saimlau/SP25ME327Team17/anim_fps15.gif

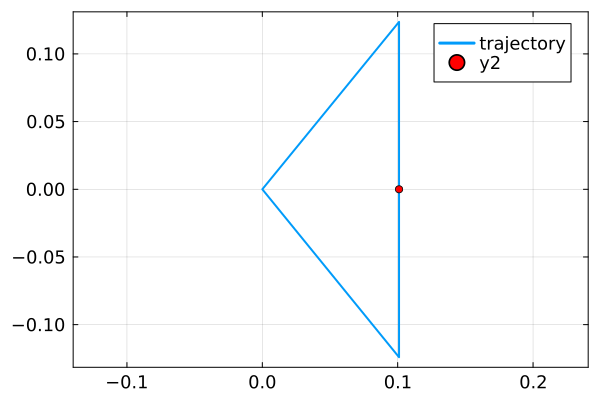
anim_fps15.gif
