saimlau/SP25ME327Team17/criticalPoints.png

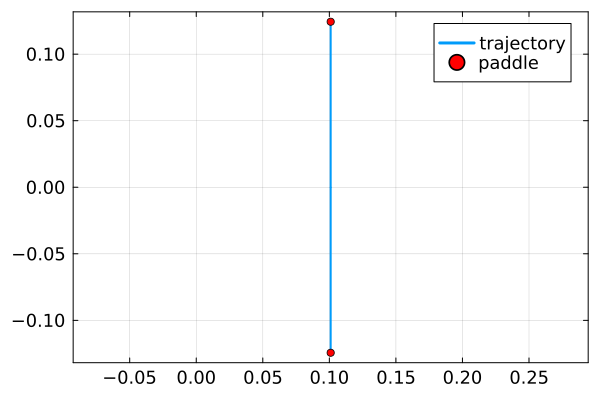
criticalPoints.png
