saimlau/SP25ME327Team17/hapticMinigamArduino/hapticMinigamArduino.ino

//--------------------------------------------------------------------------
// Code to test basic Hapkit functionality (sensing and force output)
// Code updated by Cara Nunez 4.17.19
//--------------------------------------------------------------------------
// Parameters that define what environment to render
#define ENABLE_SEND_POS
// #define ENABLE_VIBRATION

// Includes
#include <math.h>

// Pin declares
int pwmPin = 5; // PWM output pin for motor 1
int dirPin = 8; // direction output pin for motor 1
int sensorPosPin = A2; // input pin for MR sensor
int fsrPin = A3; // input pin for FSR sensor
int ermPin = 6;

// Position tracking variables
int updatedPos = 0;     // keeps track of the latest updated value of the MR sensor reading
int rawPos = 0;         // current raw reading from MR sensor
int lastRawPos = 0;     // last raw reading from MR sensor
int lastLastRawPos = 0; // last last raw reading from MR sensor
int flipNumber = 0;     // keeps track of the number of flips over the 180deg mark
int tempOffset = 0;
int rawDiff = 0;
int lastRawDiff = 0;
int rawOffset = 0;
int lastRawOffset = 0;
const int flipThresh = 700;  // threshold to determine whether or not a flip over the 180 degree mark occurred
boolean flipped = false;

// Kinematics variables
double xh = 0;           // position of the handle [m]
double theta_s = 0;      // Angle of the sector pulley in deg
double xh_prev;          // Distance of the handle at previous time step
double xh_prev2;
double dxh;              // Velocity of the handle
double dxh_prev;
double dxh_prev2;
double dxh_filt;         // Filtered velocity of the handle
double dxh_filt_prev;
double dxh_filt_prev2;

//*****************************************************************
//****************** Initialize Variables (START) *****************
//*****************************************************************
// Parameters & variables for wall and mass-spring-damper system

// STUDENT CODE HERE
double x_wall = 0.005;
double k_wall = 150;
double rh = 0.089;    //[m]
double rp = 0.00525;   //[m]
double rs = 0.074;   //[m] 
double m = 2;
double b = 1;
double k_sp = 300;
double k_user = 1000;
double x_mqe = 0.005;
double x_mass = 0.005;
double ddx_mass;
double dx_mass;
double ddx_mass_prev = 0;
double dx_mass_prev = 0;
double dt = 0.001;
double r_m = 0.002;
double r_u = 0.002;

int count_down = 0;

//*****************************************************************
//******************* Initialize Variables (END) ******************
//*****************************************************************

// Force output variables
double force = 0;           // force at the handle
double Tp = 0;              // torque of the motor pulley
double duty = 0;            // duty cylce (between 0 and 255)
unsigned int output = 0;    // output command to the motor


// --------------------------------------------------------------
// Setup function -- NO NEED TO EDIT
// --------------------------------------------------------------
void setup() 
{
  // Set up serial communication
  Serial.begin(115200);
  
  // Set PWM frequency 
  setPwmFrequency(pwmPin,1); 
  
  // Input pins
  pinMode(sensorPosPin, INPUT); // set MR sensor pin to be an input
  pinMode(fsrPin, INPUT);       // set FSR sensor pin to be an input

  // Output pins
  pinMode(pwmPin, OUTPUT);  // PWM pin for motor A
  pinMode(dirPin, OUTPUT);  // dir pin for motor A
  pinMode(ermPin, OUTPUT);
  
  // Initialize motor 
  analogWrite(pwmPin, 0);     // set to not be spinning (0/255)
  digitalWrite(dirPin, LOW);  // set direction
  
  // Initialize position valiables
  lastLastRawPos = analogRead(sensorPosPin);
  lastRawPos = analogRead(sensorPosPin);
}


// --------------------------------------------------------------
// Main Loop
// --------------------------------------------------------------
void loop()
{
  
  //*************************************************************
  //*** Section 1. Compute position in counts (do not change) ***  
  //*************************************************************

  // Get voltage output by MR sensor
  rawPos = analogRead(sensorPosPin);  //current raw position from MR sensor

  // Calculate differences between subsequent MR sensor readings
  rawDiff = rawPos - lastRawPos;          //difference btwn current raw position and last raw position
  lastRawDiff = rawPos - lastLastRawPos;  //difference btwn current raw position and last last raw position
  rawOffset = abs(rawDiff);
  lastRawOffset = abs(lastRawDiff);
  
  // Update position record-keeping vairables
  lastLastRawPos = lastRawPos;
  lastRawPos = rawPos;
  
  // Keep track of flips over 180 degrees
  if((lastRawOffset > flipThresh) && (!flipped)) { // enter this anytime the last offset is greater than the flip threshold AND it has not just flipped
    if(lastRawDiff > 0) {        // check to see which direction the drive wheel was turning
      flipNumber--;              // cw rotation 
    } else {                     // if(rawDiff < 0)
      flipNumber++;              // ccw rotation
    }
    if(rawOffset > flipThresh) { // check to see if the data was good and the most current offset is above the threshold
      updatedPos = rawPos + flipNumber*rawOffset; // update the pos value to account for flips over 180deg using the most current offset 
      tempOffset = rawOffset;
    } else {                     // in this case there was a blip in the data and we want to use lastactualOffset instead
      updatedPos = rawPos + flipNumber*lastRawOffset;  // update the pos value to account for any flips over 180deg using the LAST offset
      tempOffset = lastRawOffset;
    }
    flipped = true;            // set boolean so that the next time through the loop won't trigger a flip
  } else {                        // anytime no flip has occurred
    updatedPos = rawPos + flipNumber*tempOffset; // need to update pos based on what most recent offset is 
    flipped = false;
  }
 
  //*****************************************************************
  //************ Compute Position in Meters (START) *****************
  //*****************************************************************
  
  // STUDENT CODE HERE
  double ts = 0.015695737466075707078339007694*updatedPos -7.744974454093580540359198494116;
  xh = ts/180*PI*0.089;
  
  //*****************************************************************
  //**************** Compute Position in Meters (END) ***************
  //*****************************************************************

  // Calculate velocity with loop time estimation
  dxh = (double)(xh - xh_prev) / 0.001;

  // Calculate the filtered velocity of the handle using an infinite impulse response filter
  dxh_filt = .9*dxh + 0.1*dxh_prev; 
    
  // Record the position and velocity
  xh_prev2 = xh_prev;
  xh_prev = xh;
  
  dxh_prev2 = dxh_prev;
  dxh_prev = dxh;
  
  dxh_filt_prev2 = dxh_filt_prev;
  dxh_filt_prev = dxh_filt;
  
  //*************************************************************
  //****** Assign a Motor Output Force in Newtons (START) *******  
  //*************************************************************
  //*************************************************************
  //******************* Rendering Algorithms ********************
  //*************************************************************
  
  #ifdef ENABLE_SEND_POS
    // STUDENT CODE HERE
    Serial.println(xh, 5);
  #endif

  #ifdef ENABLE_VIBRATION
    // STUDENT CODE HERE
    force = 0;
    if (Serial.available() > 0) {
      String str = Serial.readString();
      str.trim();
      if(str==str){
        count_down = 0; // reset vibration timer
        force = -str.toFloat()/3;
      }
    }
    // if(count_down){
    //   force = -20*dxh_filt;  // vibrate
    //   count_down -= 1;
    // }
  #endif

  // Calculate the motor torque: Tp = ?
  // STUDENT CODE HERE
  Tp = rh*rp/rs*force;

  //*************************************************************
  //******* Assign a Motor Output Force in Newtons (END) ********  
  //*************************************************************
  //*************************************************************


  
  //*************************************************************
  //************ Force output (do not change) *******************
  //*************************************************************

  // Determine correct direction for motor torque
  if(force > 0) { 
    digitalWrite(dirPin, HIGH);
  } else {
    digitalWrite(dirPin, LOW);
  }

  // Compute the duty cycle required to generate Tp (torque at the motor pulley)
  duty = sqrt(abs(Tp)/0.03);

  // Make sure the duty cycle is between 0 and 100%
  if (duty > 1) {            
    duty = 1;
  } else if (duty < 0) { 
    duty = 0;
  }  
  output = (int)(duty* 255);   // convert duty cycle to output signal
  analogWrite(pwmPin,output);  // output the signal
}

// --------------------------------------------------------------
// Function to set PWM Freq -- DO NOT EDIT
// --------------------------------------------------------------
void setPwmFrequency(int pin, int divisor) {
  byte mode;
  if(pin == 5 || pin == 6 || pin == 9 || pin == 10) {
    switch(divisor) {
      case 1: mode = 0x01; break;
      case 8: mode = 0x02; break;
      case 64: mode = 0x03; break;
      case 256: mode = 0x04; break;
      case 1024: mode = 0x05; break;
      default: return;
    }
    if(pin == 5 || pin == 6) {
      TCCR0B = TCCR0B & 0b11111000 | mode;
    } else {
      TCCR1B = TCCR1B & 0b11111000 | mode;
    }
  } else if(pin == 3 || pin == 11) {
    switch(divisor) {
      case 1: mode = 0x01; break;
      case 8: mode = 0x02; break;
      case 32: mode = 0x03; break;
      case 64: mode = 0x04; break;
      case 128: mode = 0x05; break;
      case 256: mode = 0x06; break;
      case 1024: mode = 0x7; break;
      default: return;
    }
    TCCR2B = TCCR2B & 0b11111000 | mode;
  }
}
